srk0102/boat-tracker/images/install_guide/2-5VPS.jpg

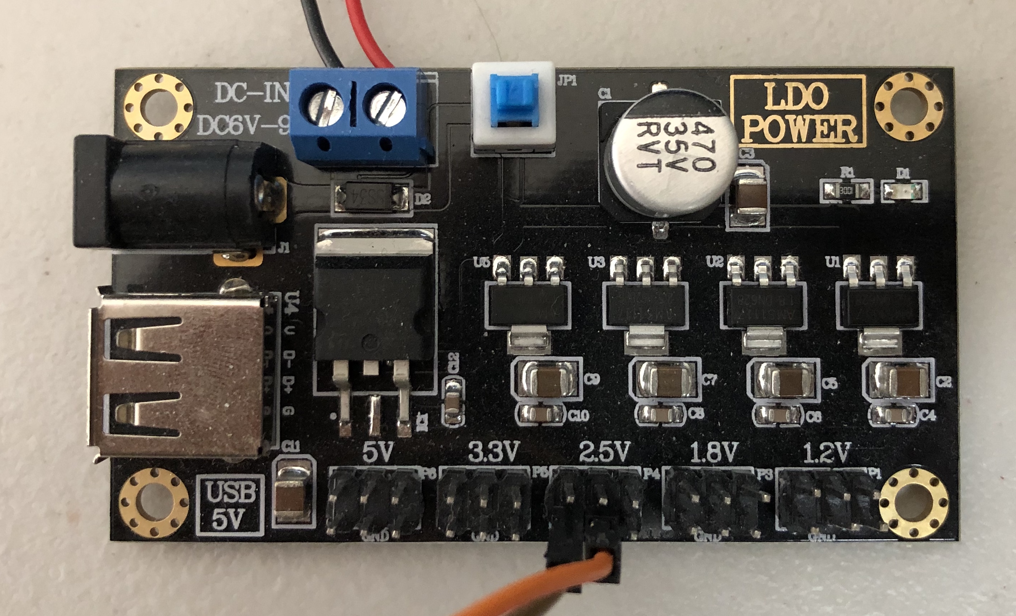
images/install_guide/2-5VPS.jpg
