srk0102/boat-tracker/images/install_guide/motor-driver-address.jpg

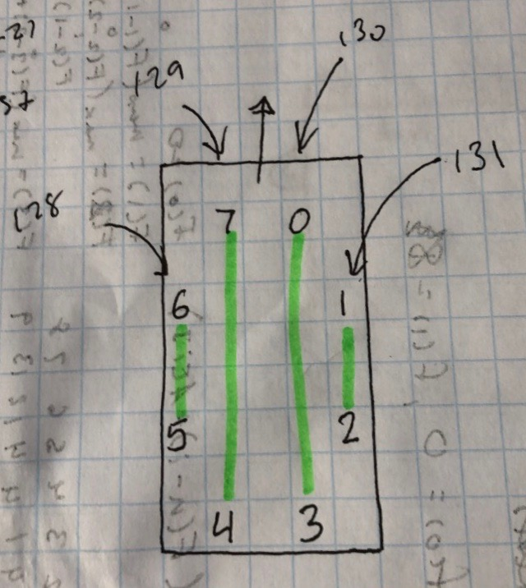
images/install_guide/motor-driver-address.jpg
