srk0102/boat-tracker/module-sabertooth/README.md

# module-sabertooth

This folder contains testing sending packetized serial commands to the Sabertooth motor drivers
