srk0102/boat-tracker/images/driver.jpeg

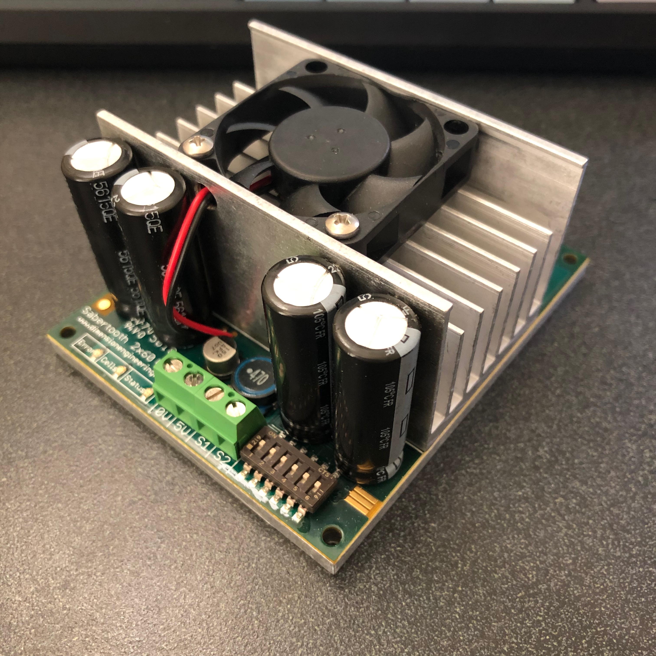
images/driver.jpeg
