srk0102/boat-tracker/images/gantt.png

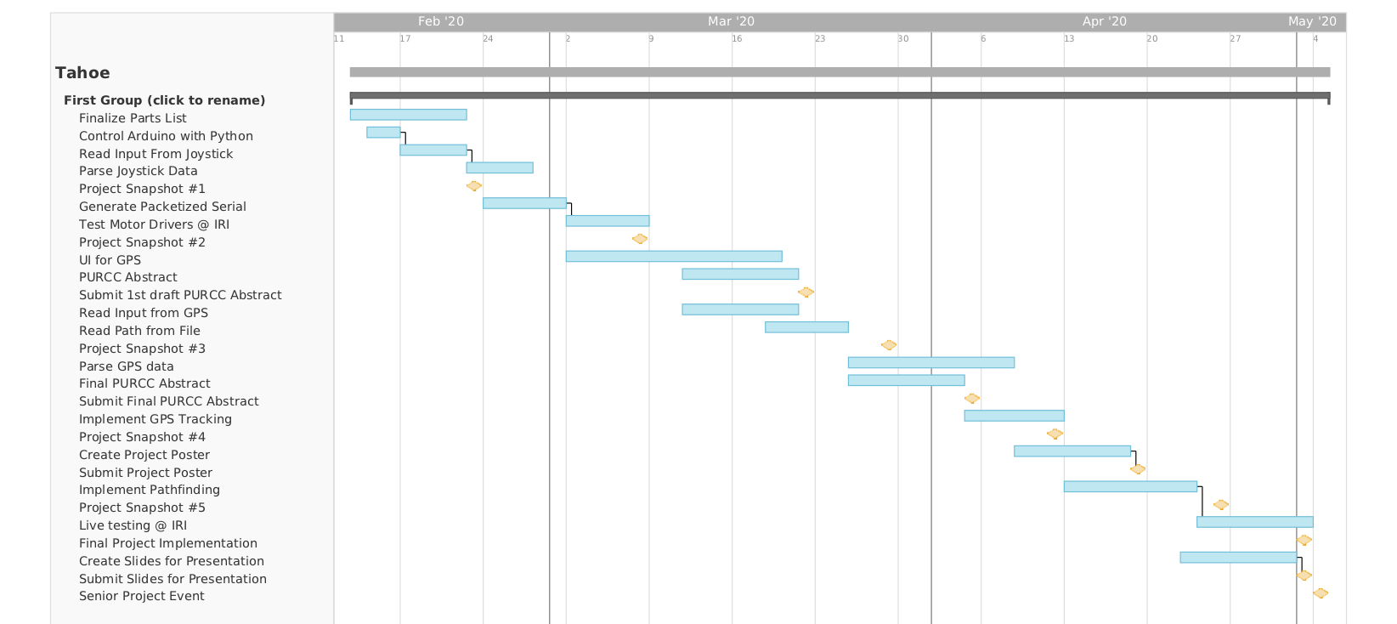
images/gantt.png
