srk0102/boat-tracker/images/headless-diagram.jpg

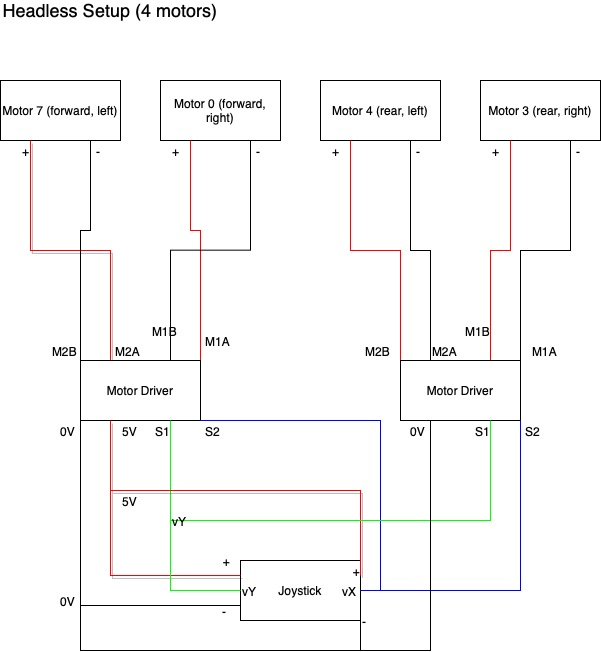
images/headless-diagram.jpg
