srk0102/boat-tracker/images/joystick.jpeg

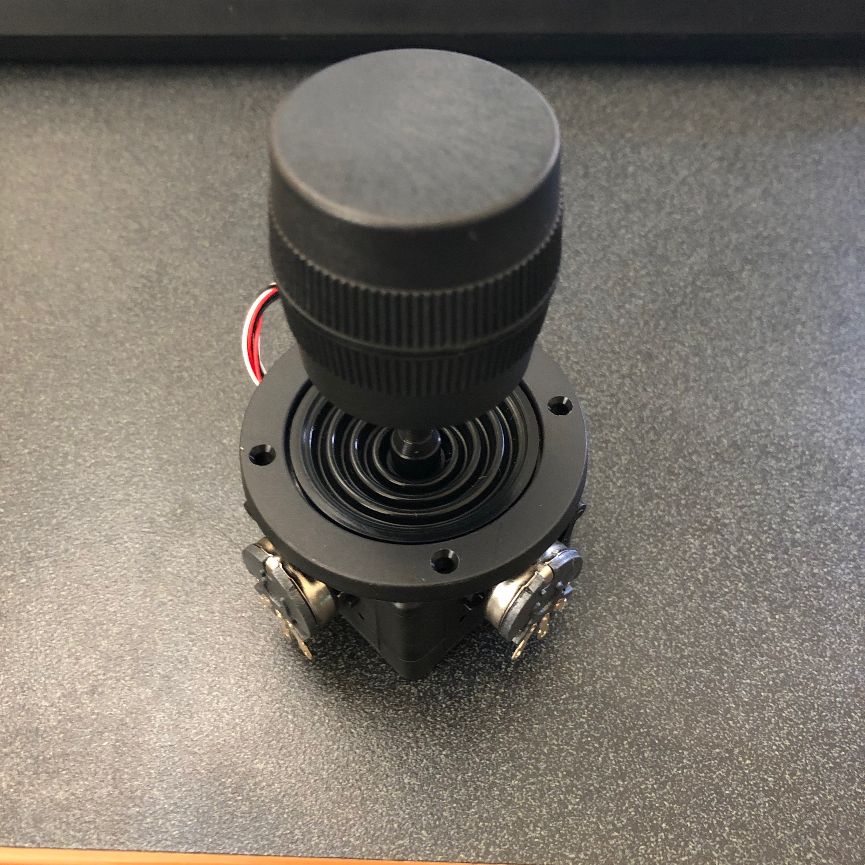
images/joystick.jpeg
