srk0102/boat-tracker/images/motor-naming.jpg

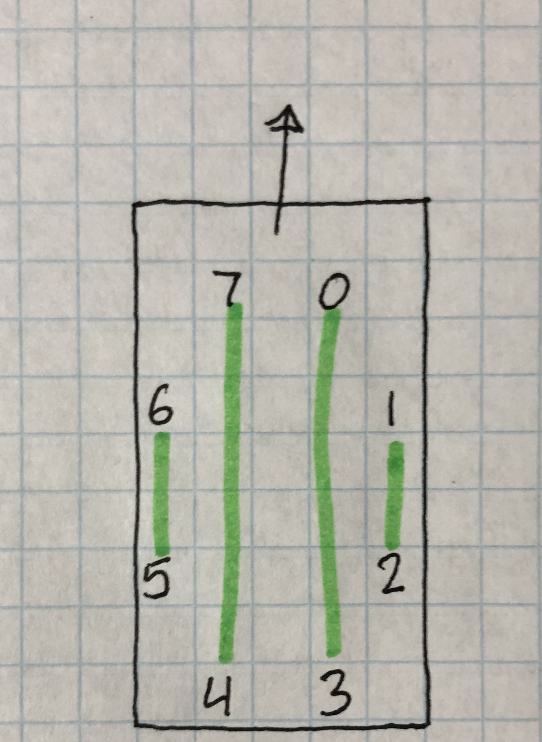
images/motor-naming.jpg
