srk0102/boat-tracker/images/platform.jpg

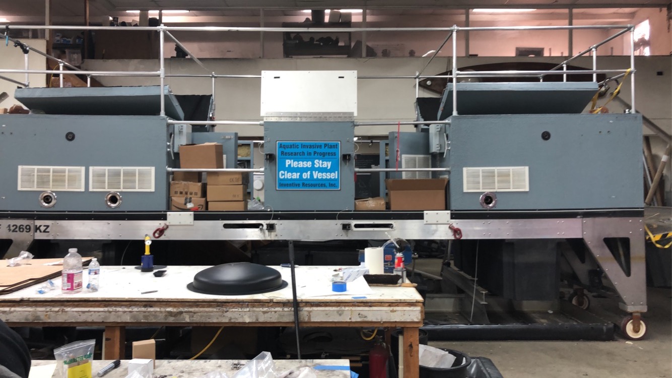
images/platform.jpg
