srk0102/boat-tracker/images/ps-addresses.png

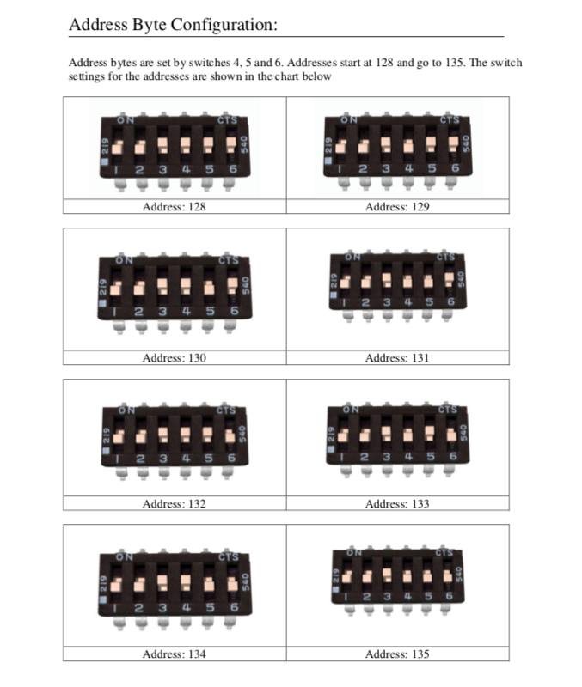
images/ps-addresses.png
