srk0102/boat-tracker/images/RTK-sample.PNG

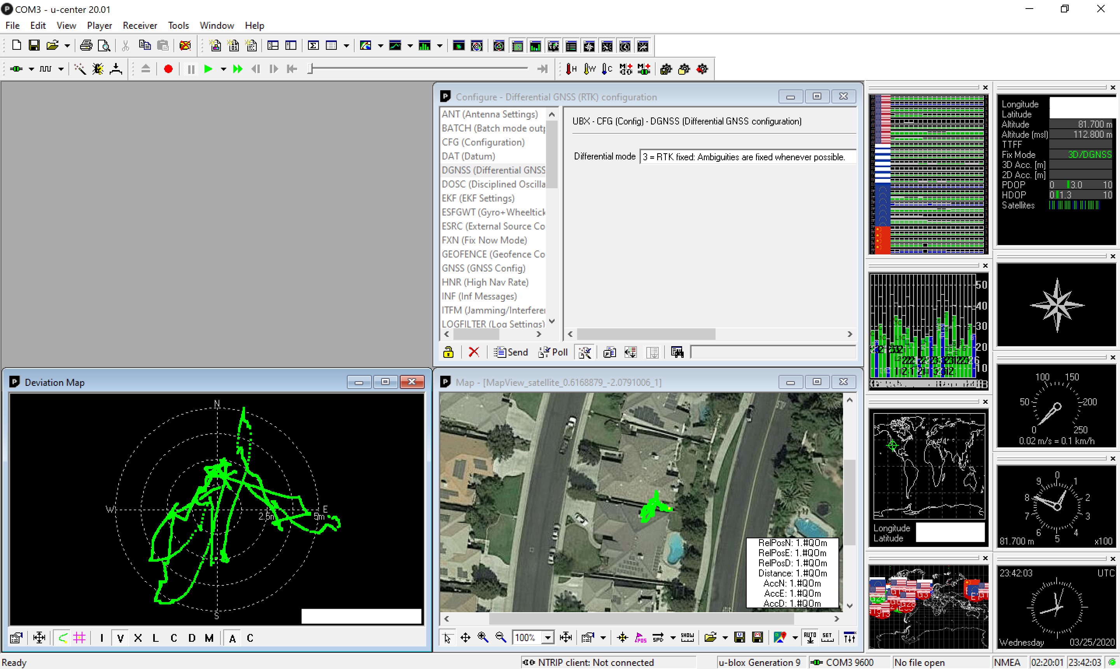
images/RTK-sample.PNG
