srk0102/boat-tracker/images/partslist-feb-02-2020.png

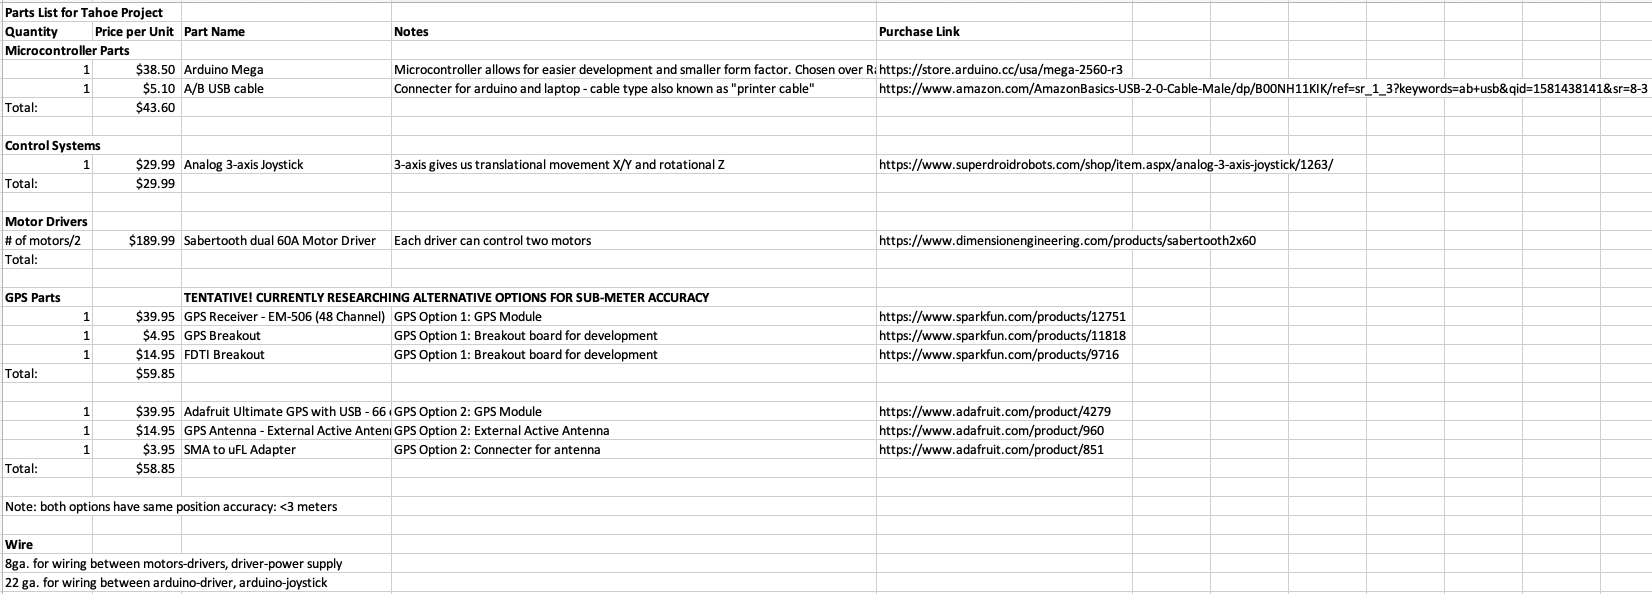
images/partslist-feb-02-2020.png
