srk0102/boat-tracker/images/partslist-final.png

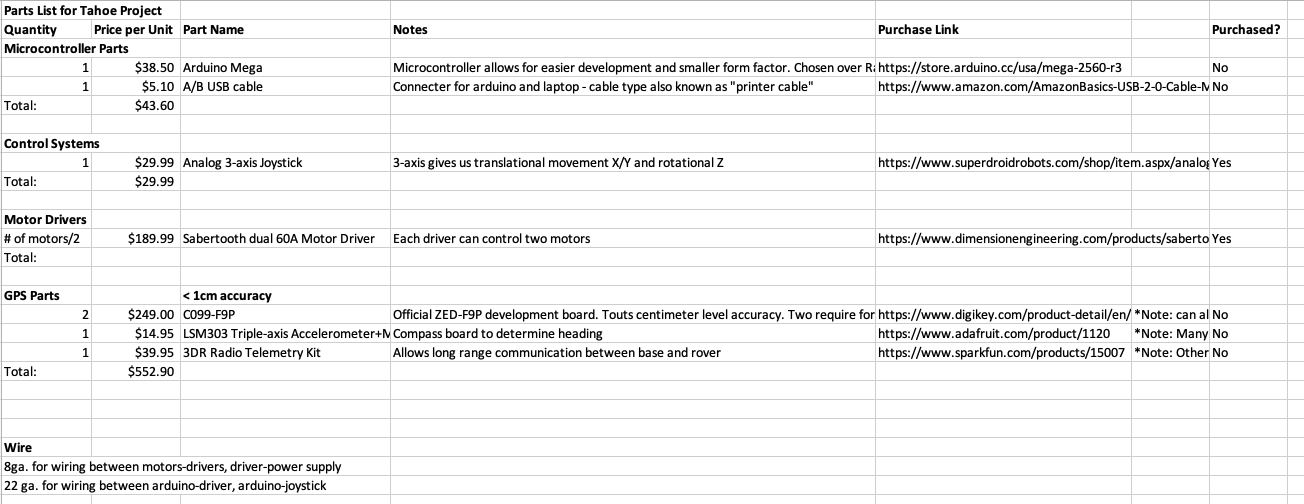
images/partslist-final.png
