srk0102/boat-tracker/developermanual.docx

Inventive Resources Incorporated

UV-C Vessel

Propulsion Control System

Developer’s Manual

Author: Alexander Ng

Last modified: 4/1/20
