srk0102/boat-tracker/images/headless-wiring-final.png

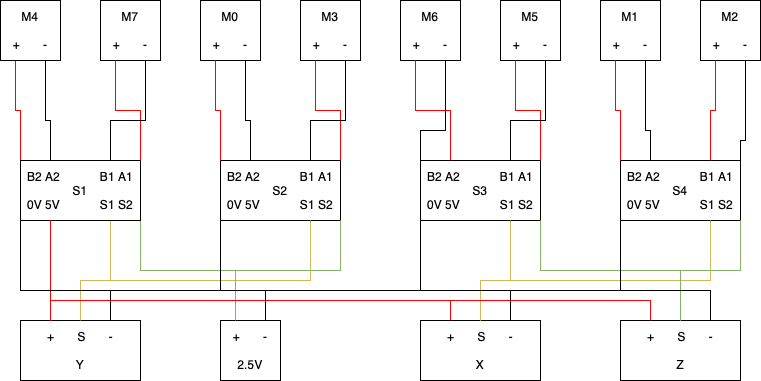
images/headless-wiring-final.png
