srk0102/boat-tracker/images/install_guide/Arduino-manual-setup.jpg

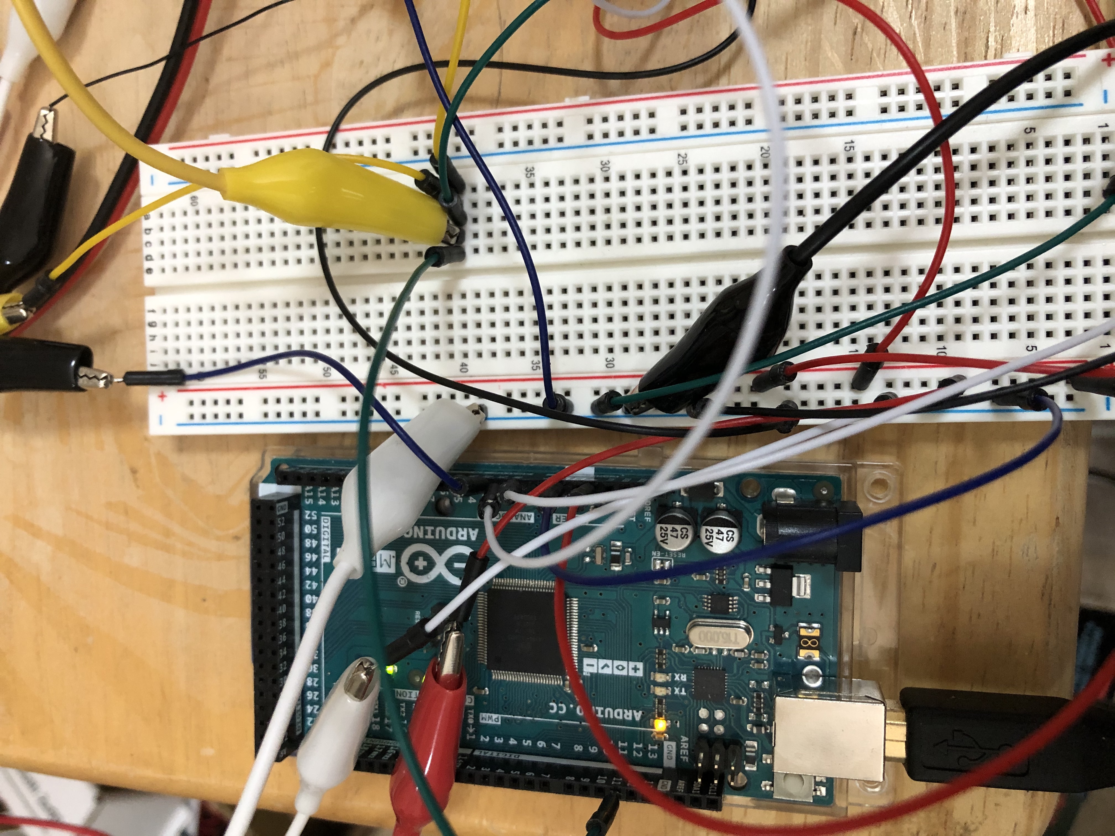
images/install_guide/Arduino-manual-setup.jpg
