srk0102/boat-tracker/images/install_guide/arduino-manual-wiring.jpg

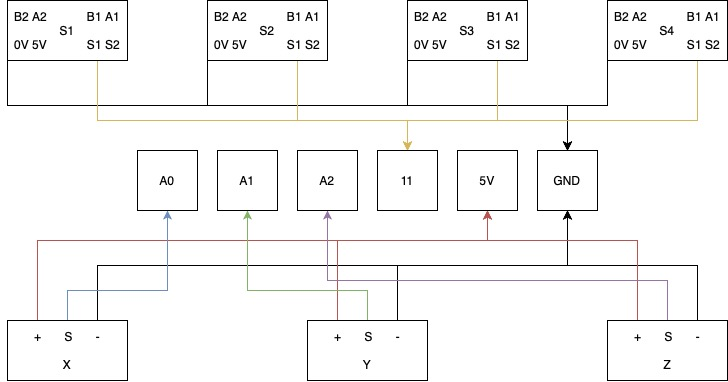
images/install_guide/arduino-manual-wiring.jpg
