srk0102/boat-tracker/images/install_guide/arduino_ide_dl.png

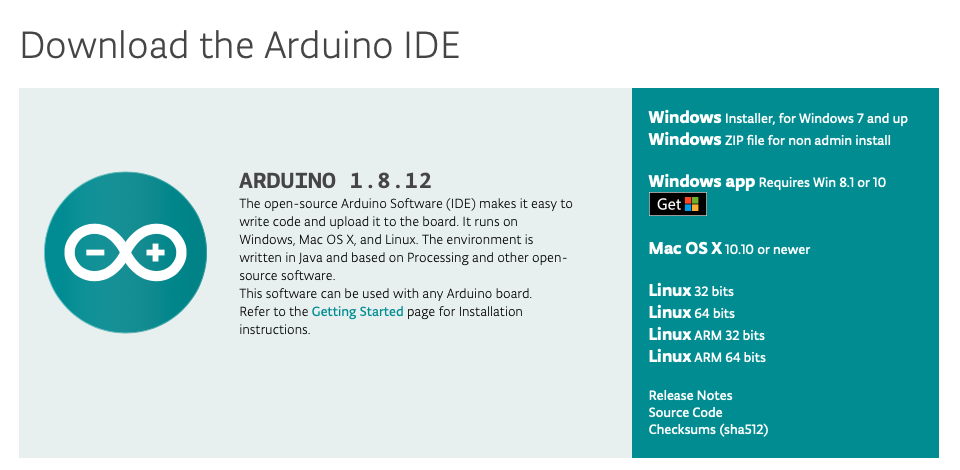
images/install_guide/arduino_ide_dl.png
