srk0102/boat-tracker/images/install_guide/arduino_prog_load.png

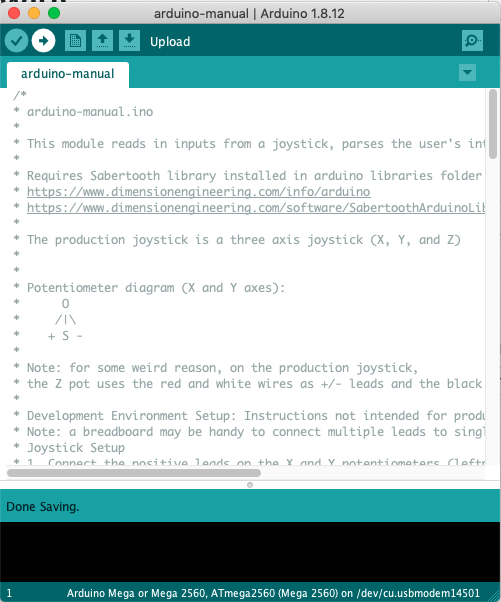
images/install_guide/arduino_prog_load.png
