srk0102/boat-tracker/images/install_guide/DIP-switches.png

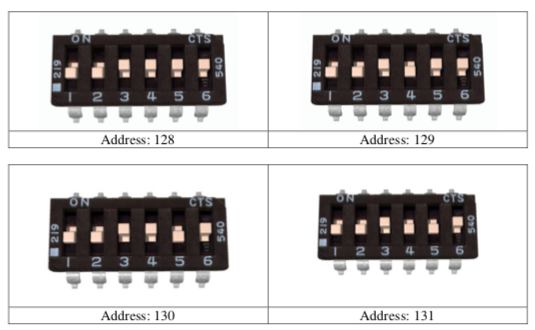
images/install_guide/DIP-switches.png
