srk0102/boat-tracker/images/install_guide/joystick-wiring-detail.jpg

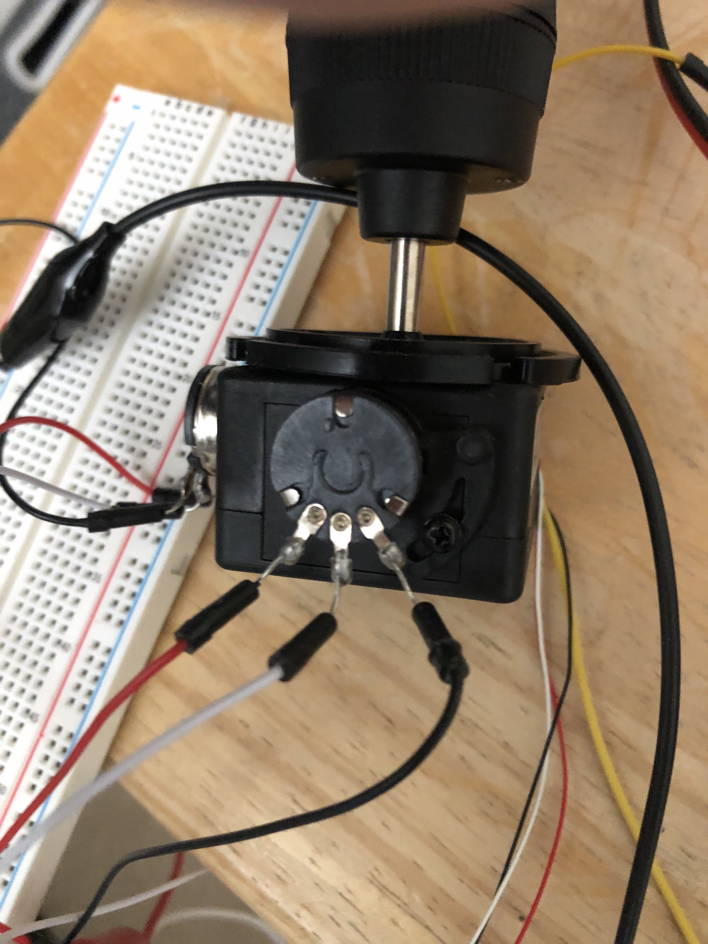
images/install_guide/joystick-wiring-detail.jpg
