srk0102/boat-tracker/images/install_guide/joystick_connections.jpg

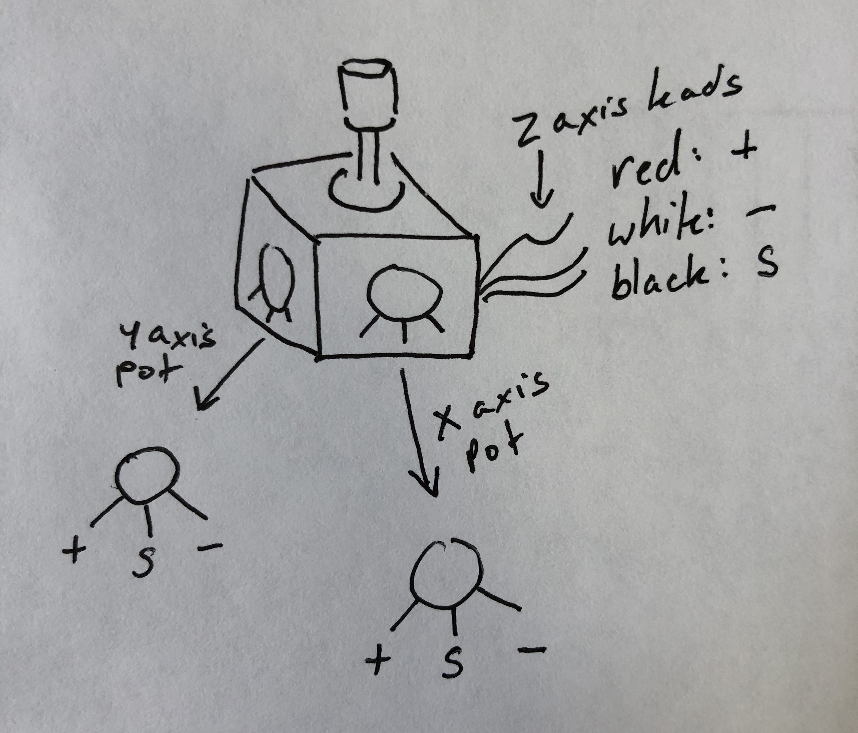
images/install_guide/joystick_connections.jpg
