srk0102/boat-tracker/images/install_guide/saber_library.png

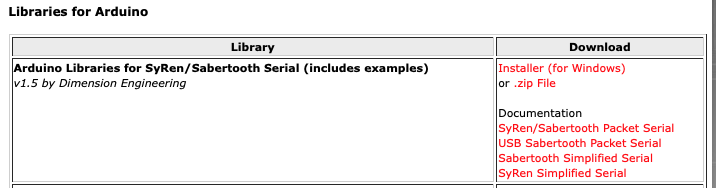
images/install_guide/saber_library.png
