srk0102/boat-tracker/images/GNSS-test.bmp

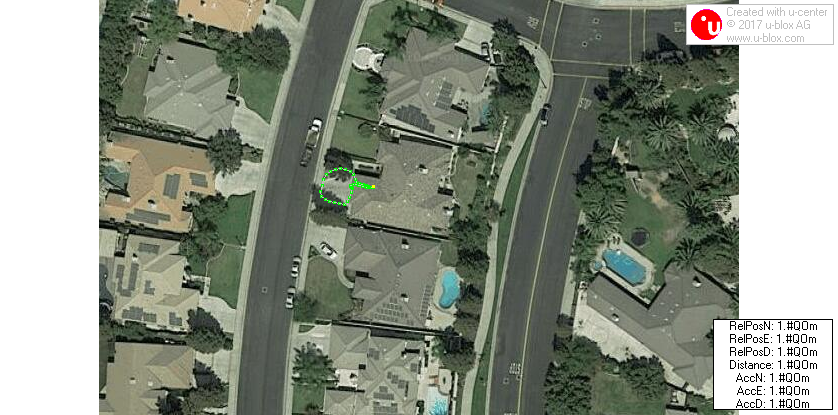
images/GNSS-test.bmp
