srk0102/boat-tracker/module-joystick/joystick_test/output.png

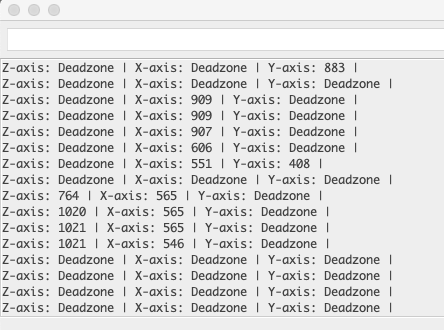
module-joystick/joystick_test/output.png
