srk0102/boat-tracker/(commit log)

2020-05-16 Create file for driver component
2020-05-29 implement tracking timer and add image
2020-06-06 Added Config tab w/ open file button
2021-05-05 switch gps to usb source, log location every .5s
2021-08-27 Missing print statement
2021-08-30 Fix print statement
2022-01-06 remove deprecated code (#23)
    arduino and non-used controller code removed
2022-01-28 Gps distance (#30)
    * Resize sidebar in anticipation of dist table
    * Remove padding on table cells
    * Initialize dist table
    * Gitignore update
    * Comment
    * Implement update loop, functional add/clear buttons
    * Minor compatibility fix for css
    * Implement haversine formula
    * Refactor functions into separate files (#29)
    * refactor sidebar code to separate files
    * move import statements
    * add delta columns
    * pins points on map, logs points
    * remove errant console log
2022-06-09 Add custom pin asset (#38)
