srk0102/boat-tracker/images/Bread_Board[1].jpg

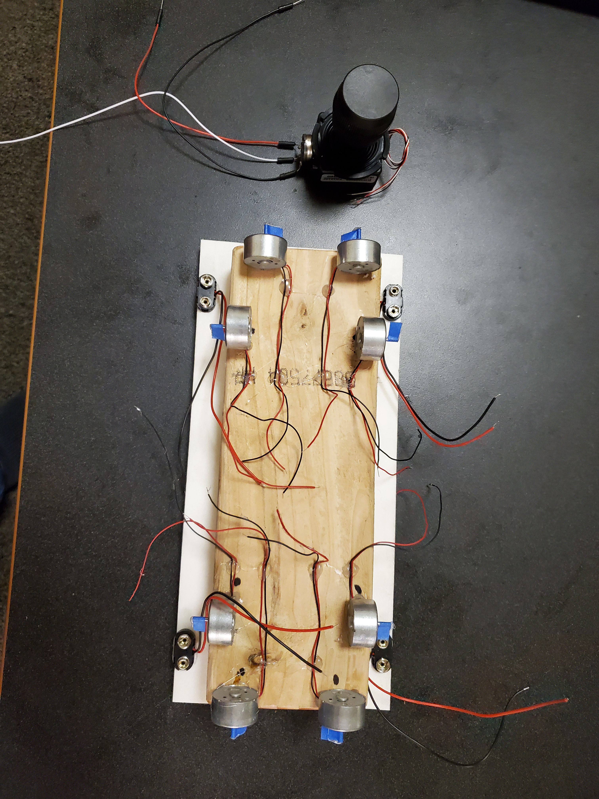
images/Bread_Board[1].jpg
